INSA-GEI/Helicoptere/docs/adhesif-de-signalisation-danger-attention-aux-mai.jpg

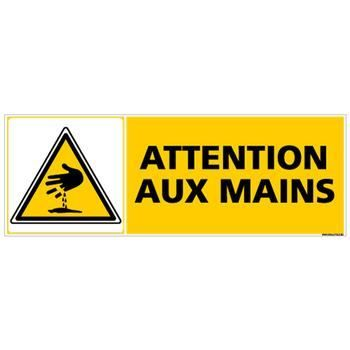
docs/adhesif-de-signalisation-danger-attention-aux-mai.jpg
