INSA-GEI/Helicoptere/docs/Danger_mains.png

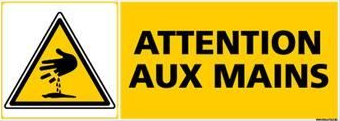
docs/Danger_mains.png
