INSA-GEI/Helicoptere/README.md

# Helicoptere
Modèle hélicoptère développé au GEI et utilisé en automatique 4éme année GEI
