INSA-GEI/Helicoptere/docs/25335-500.jpg

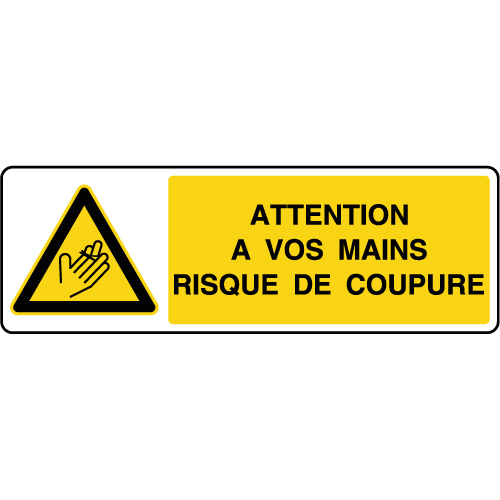
docs/25335-500.jpg
