INSA-GEI/Helicoptere/docs/AVE123_RisqueDeCoupure.jpg

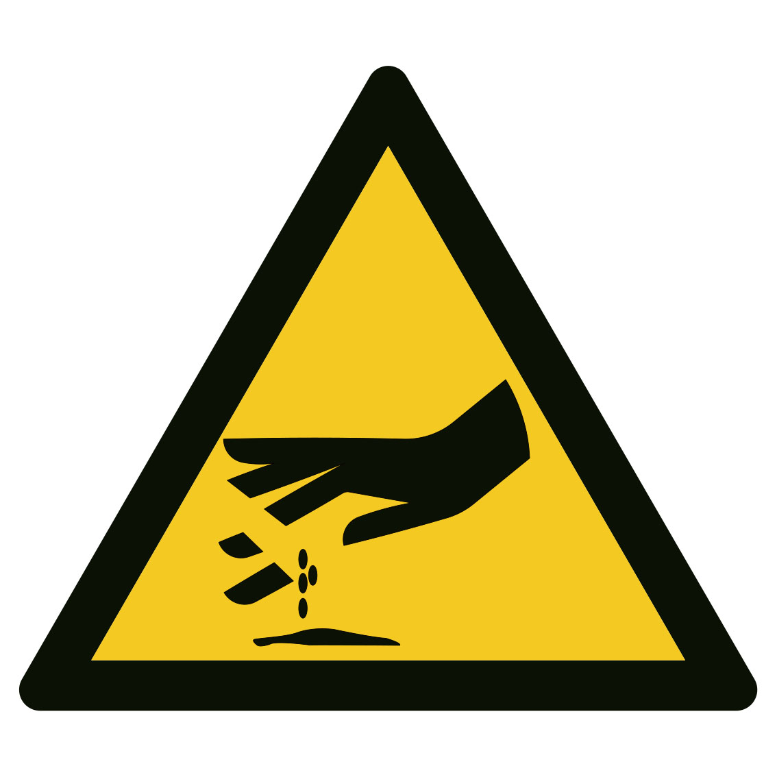
docs/AVE123_RisqueDeCoupure.jpg
