INSA-GEI/Helicoptere/docs/c0460_risque_projection-z.jpg

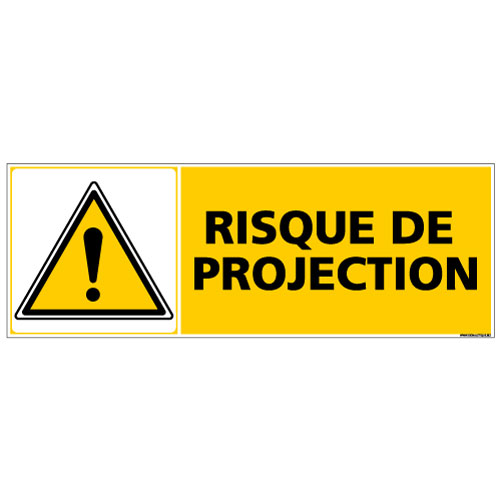
docs/c0460_risque_projection-z.jpg
