INSA-GEI/Helicoptere/docs/Danger_mains_2.png

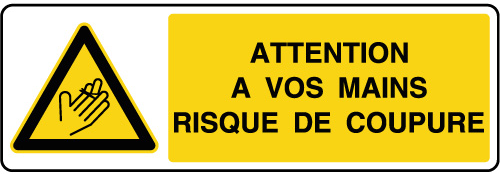
docs/Danger_mains_2.png
