INSA-GEI/Helicoptere/docs/Danger_projections.png

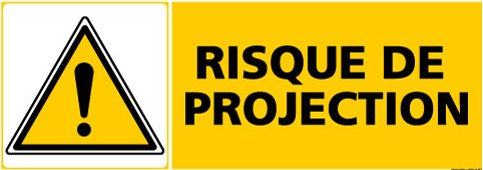
docs/Danger_projections.png
