INSA-GEI/Helicoptere/docs/StabArrowComplet.png

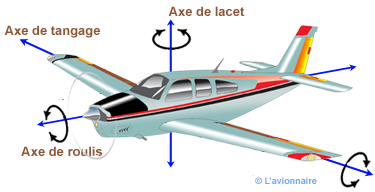
docs/StabArrowComplet.png
