INSA-GEI/Helicoptere/docs/uml/Diagramme de séquences.png

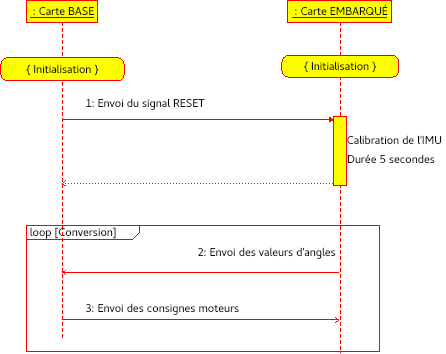
docs/uml/Diagramme de séquences.png
