INSA-GEI/Helicoptere/hardware/freecad/Helicoptere.FCStd

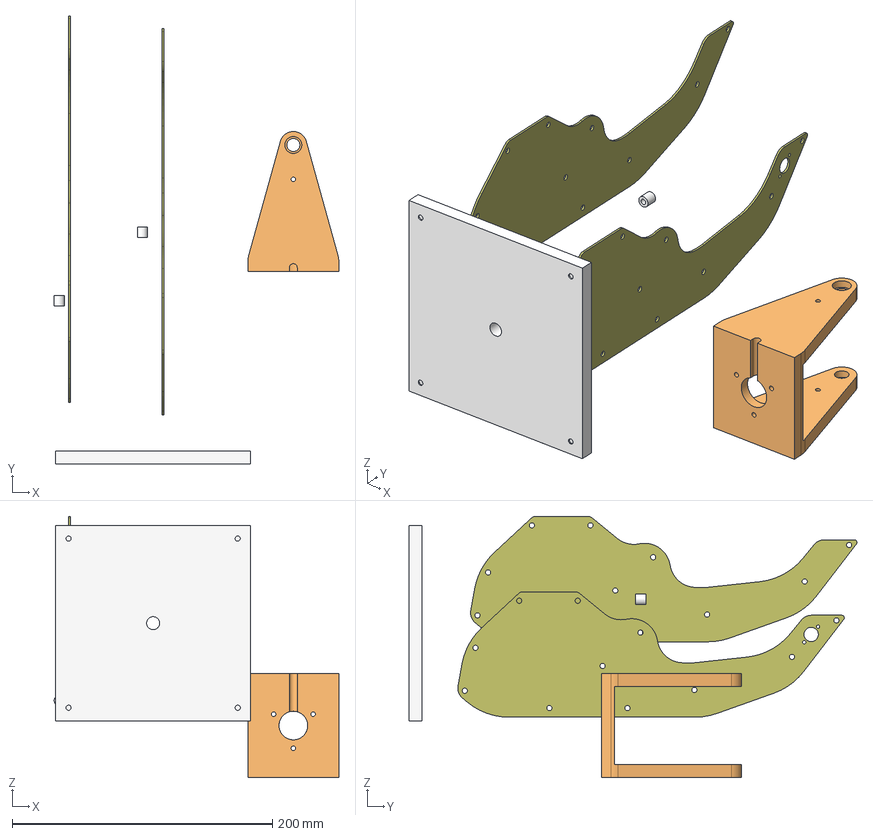
[picture p10: CAD file, 2019-09-24]
hardware/freecad/Helicoptere.FCStd
218.9 x 344.4 x 200.8 mm
Cote_Droit
Cote_Gauche
Potence
Bague_1
Bague_2
Base
