INSA-GEI/Helicoptere/pcb/Modeles 3D/STEP-WE-PD-7332-Metal-rev1.stp

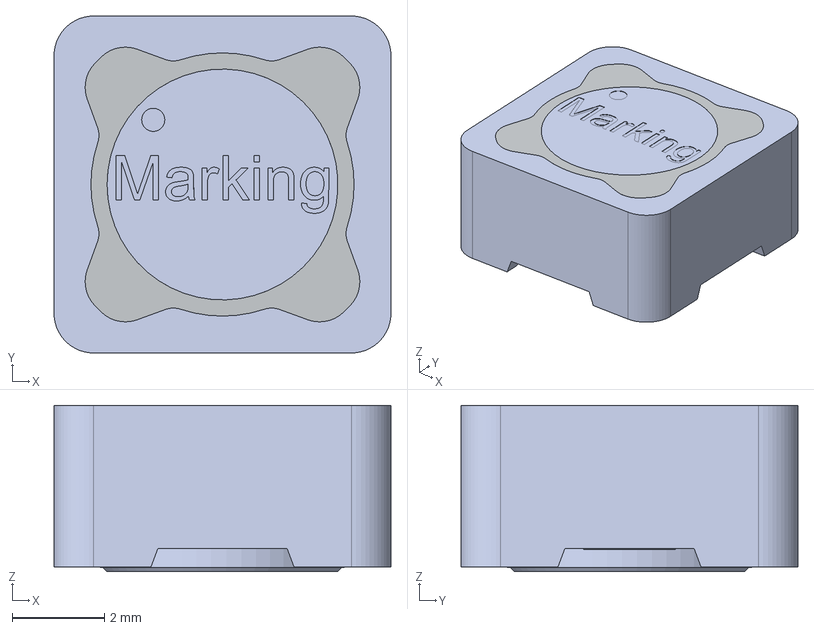
[picture p11: CAD file, 2019-10-01]
pcb/Modeles 3D/STEP-WE-PD-7332-Metal-rev1.stp
7.30 x 7.30 x 3.60 mm
Ring
Core
Base x 2
Glue x 3
