INSA-GEI/Helicoptere/hardware/Bague.step

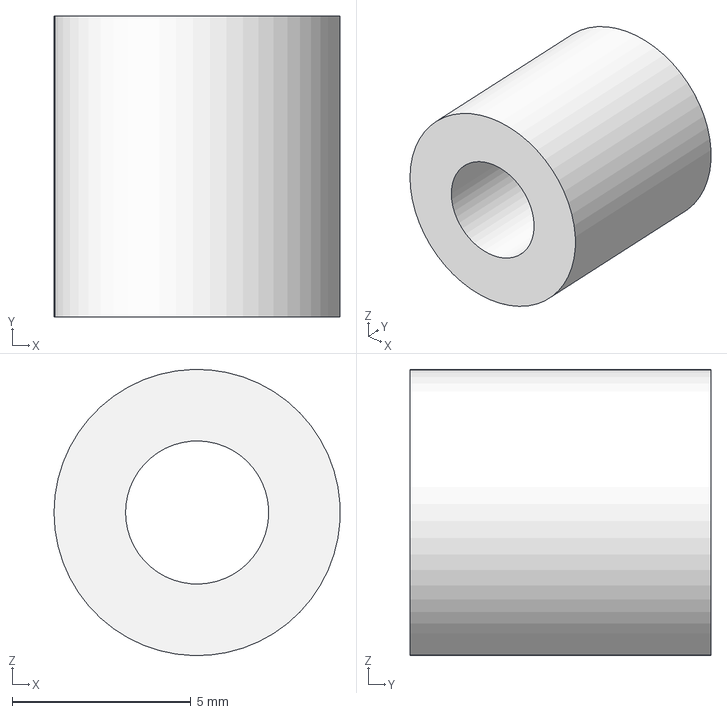
[picture p12: CAD file, 2019-09-24]
hardware/Bague.step
7.99 x 8.40 x 8.00 mm
