INSA-GEI/Helicoptere/pcb/Modeles 3D/SRN6028 series.stp

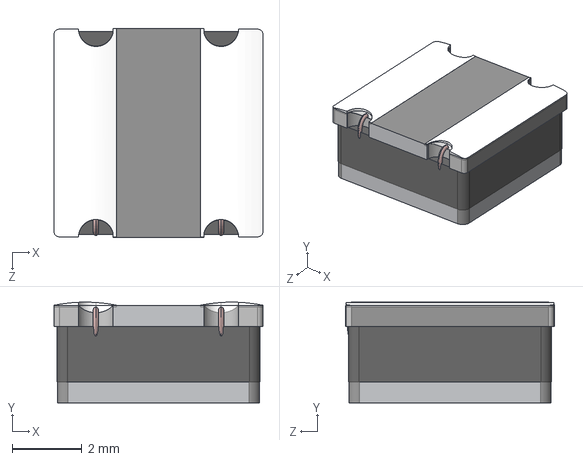
[picture p13: CAD file, 2019-10-01]
pcb/Modeles 3D/SRN6028 series.stp
6.00 x 2.89 x 6.00 mm
