INSA-GEI/Helicoptere/hardware/Base.step

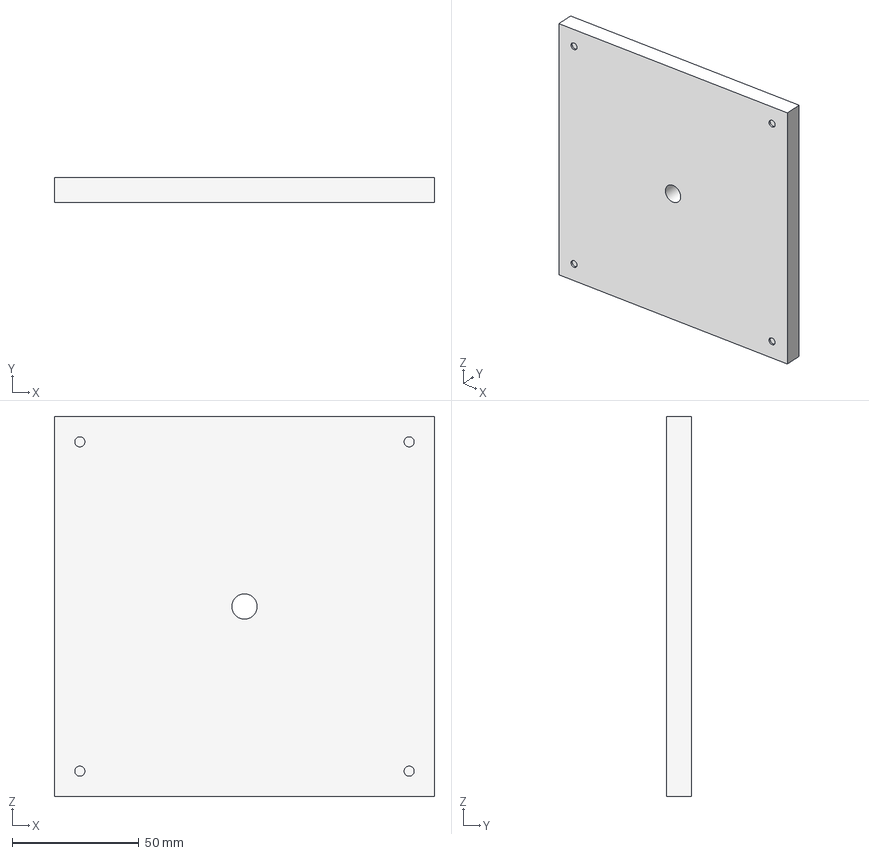
[picture p14: CAD file, 2019-09-24]
hardware/Base.step
150.0 x 10.0 x 150.0 mm
