INSA-GEI/Helicoptere/pcb/Modeles 3D/STP_MAX-WE-PD-6033-rev1.stp

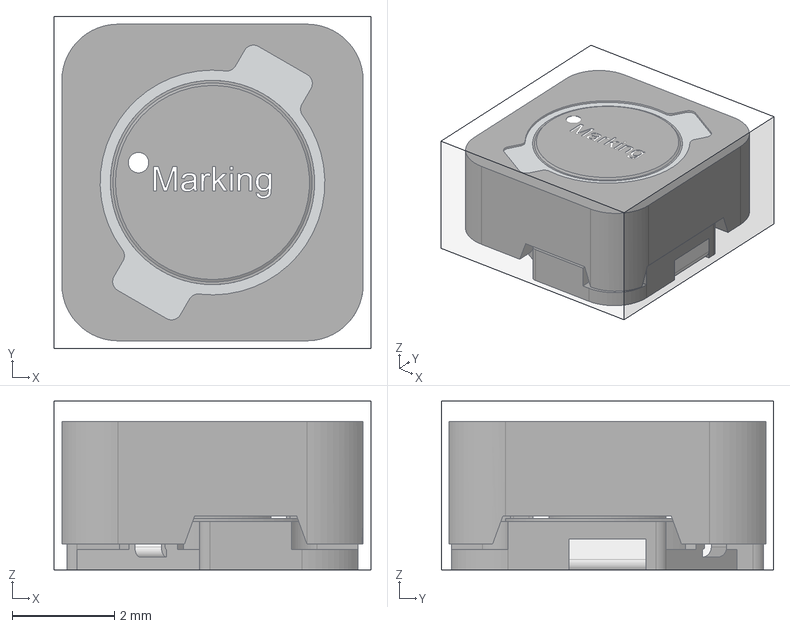
[picture p15: CAD file, 2019-10-01]
pcb/Modeles 3D/STP_MAX-WE-PD-6033-rev1.stp
6.20 x 6.50 x 3.30 mm
Base
Pin x 2
glue
Core
Shielding
MaxSized-Square
