INSA-GEI/Helicoptere/hardware/Cote_Gauche.stp

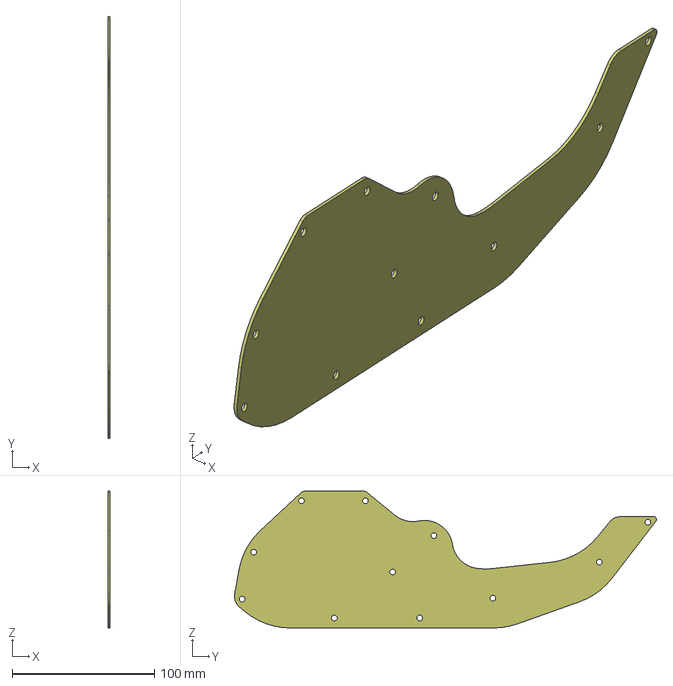
[picture p16: CAD file, 2019-09-24]
hardware/Cote_Gauche.stp
1.60 x 297.1 x 96.4 mm
