INSA-GEI/Helicoptere/pcb/Modeles 3D/STEP-WE-PD-6033-rev1.stp

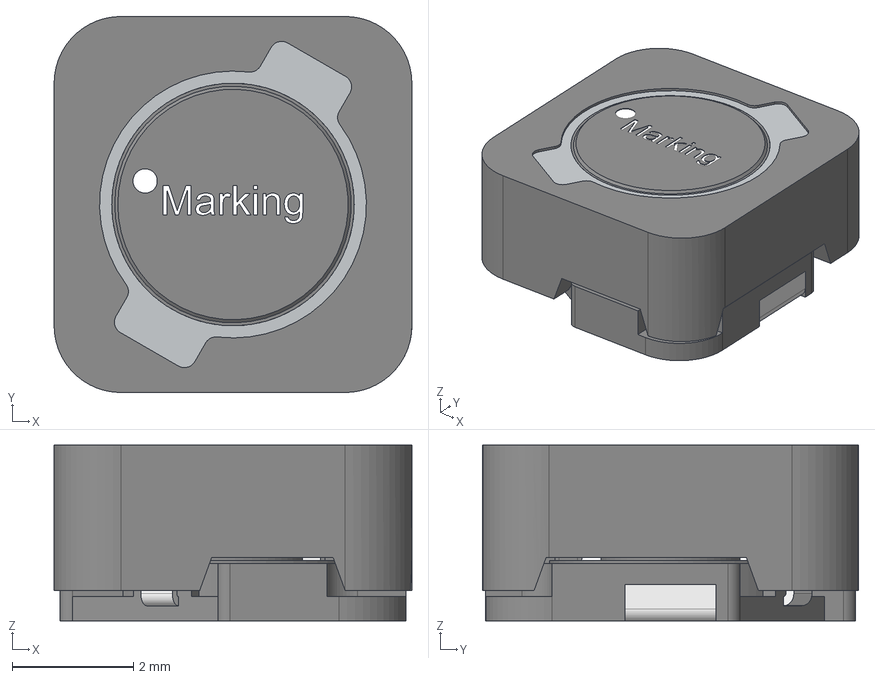
[picture p17: CAD file, 2019-10-01]
pcb/Modeles 3D/STEP-WE-PD-6033-rev1.stp
5.90 x 6.20 x 2.90 mm
Base
Pin x 2
glue
Core
Shielding
