INSA-GEI/Helicoptere/hardware/Potence.step

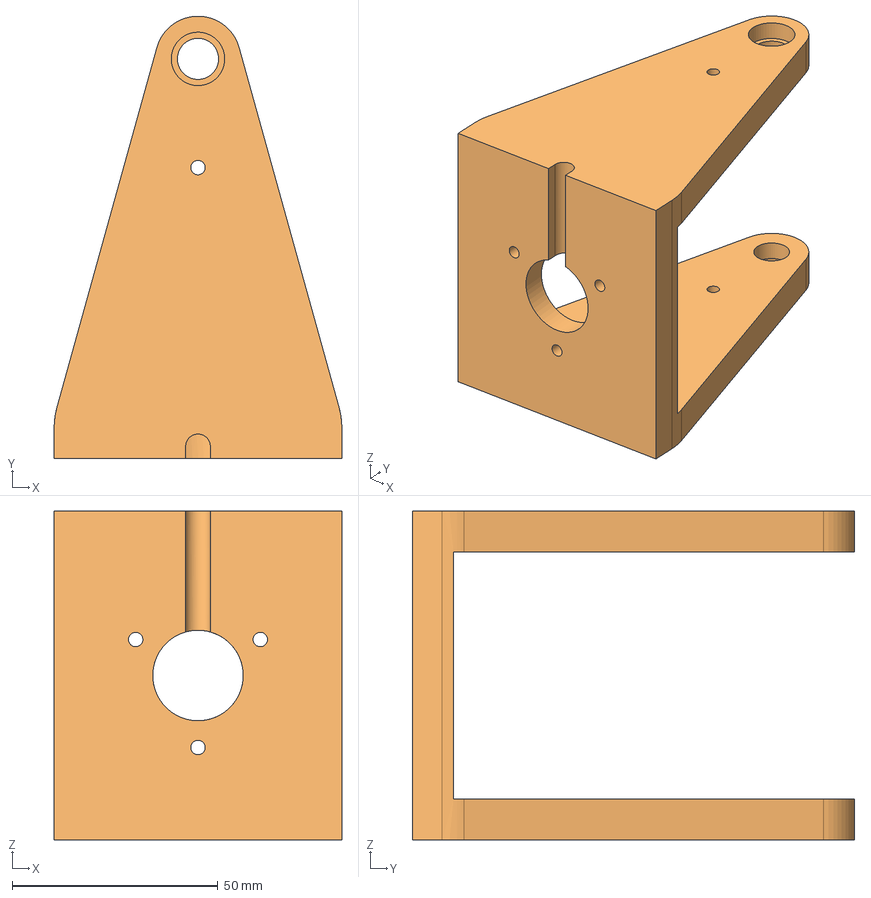
[picture p18: CAD file, 2019-09-24]
hardware/Potence.step
70.0 x 107.6 x 80.0 mm
