INSA-GEI/Helicoptere/(list of files, cad)

Other CAD files:
hardware/Raccord-Mat-Potence.dwg
hardware/Fixation-potar.dwg
hardware/Cote_Droit.stp
hardware/Bague.dwg
hardware/Bague.ipt
hardware/Base.ipt
hardware/Bouchon PVC.ipt
hardware/Cote_Droit.ipt
hardware/Cote_Droit.stl
hardware/Cote_Gauche.ipt
hardware/Cote_Gauche.stl
hardware/Entretoise-50mm.ipt
hardware/Equerre-Potar.ipt
hardware/Fixation-potar.ipt
hardware/Fixation_moteur.ipt
hardware/Helice 4.5x4.5.ipt
hardware/Helice 7x3.ipt
hardware/Helicopter_INSA_150.iam
hardware/Mat.ipt
hardware/Nidec_DMN29.ipt
hardware/Nidec_DMN37.ipt
hardware/Pied.ipt
hardware/Potence.ipt
hardware/Raccord-Mat-Potence.ipt
hardware/Roulement.ipt
hardware/SRC022.ipt
hardware/Tube-4mm.ipt
hardware/Vis-Pivot.ipt
hardware/Vishay-157.ipt
hardware/freecad/Bague.FCStd
hardware/freecad/Base.FCStd
