INSA-GEI/Helicoptere/pcb/carte_embarque/carte_embarque.pdf

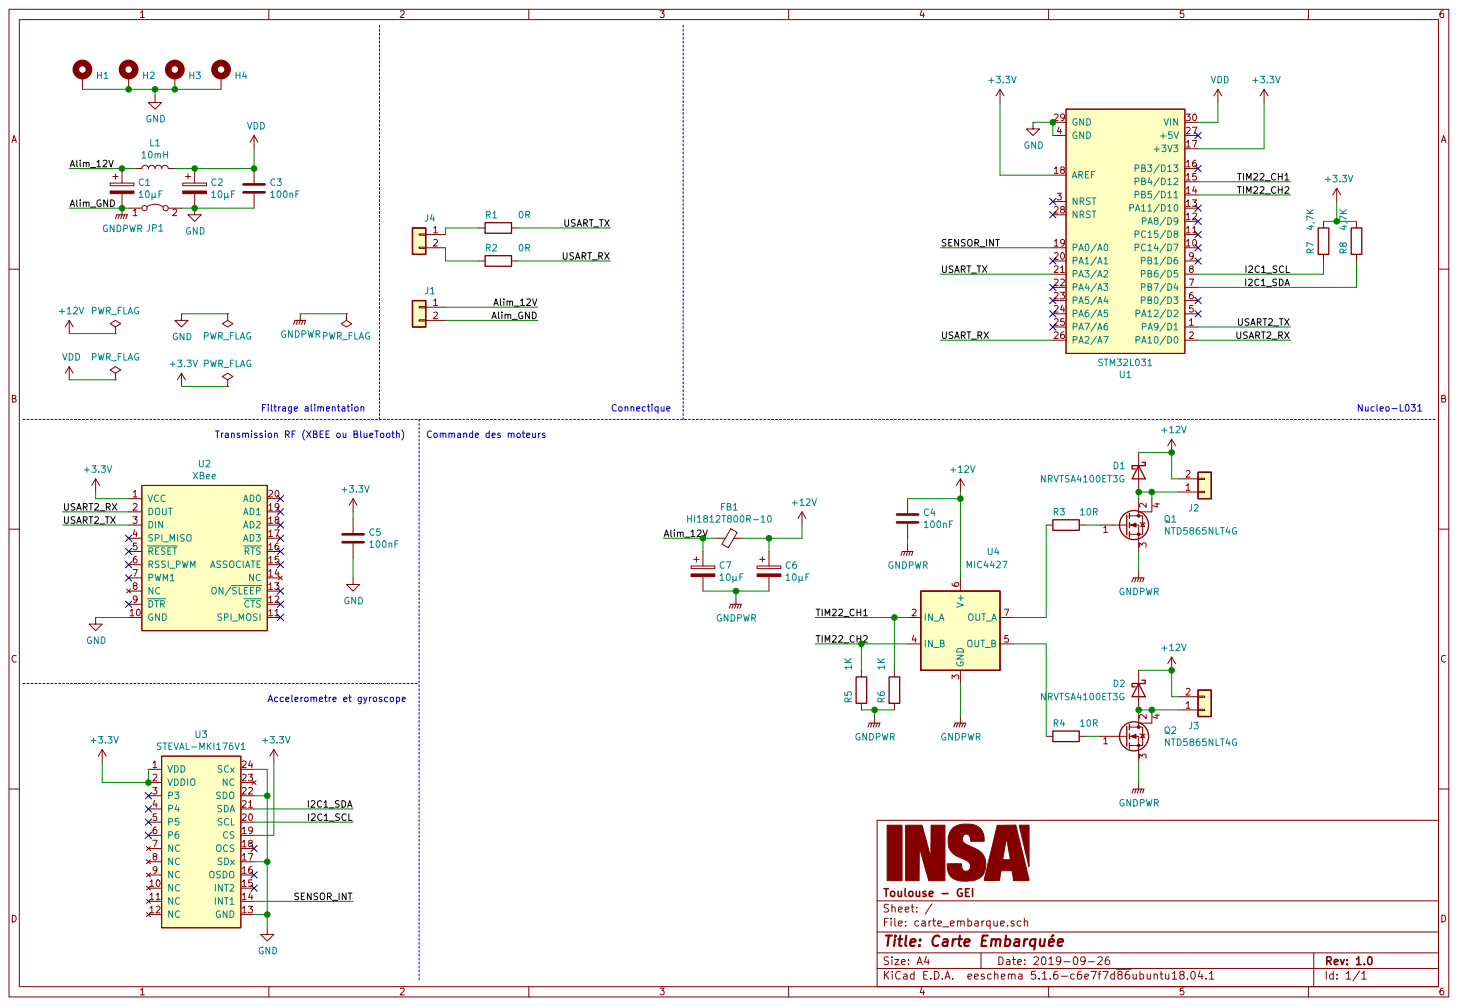
[picture p19: page 1]

File: carte_embarque.sch Sheet: / Toulouse - GEI

Id: 1/1 Title: Carte Embarquée
