INSA-GEI/Helicoptere/pcb/carte_embarque/carte_embarque.kicad_pcb

## KiCad design pcb/carte_embarque/carte_embarque.kicad_pcb (2019-10-11)

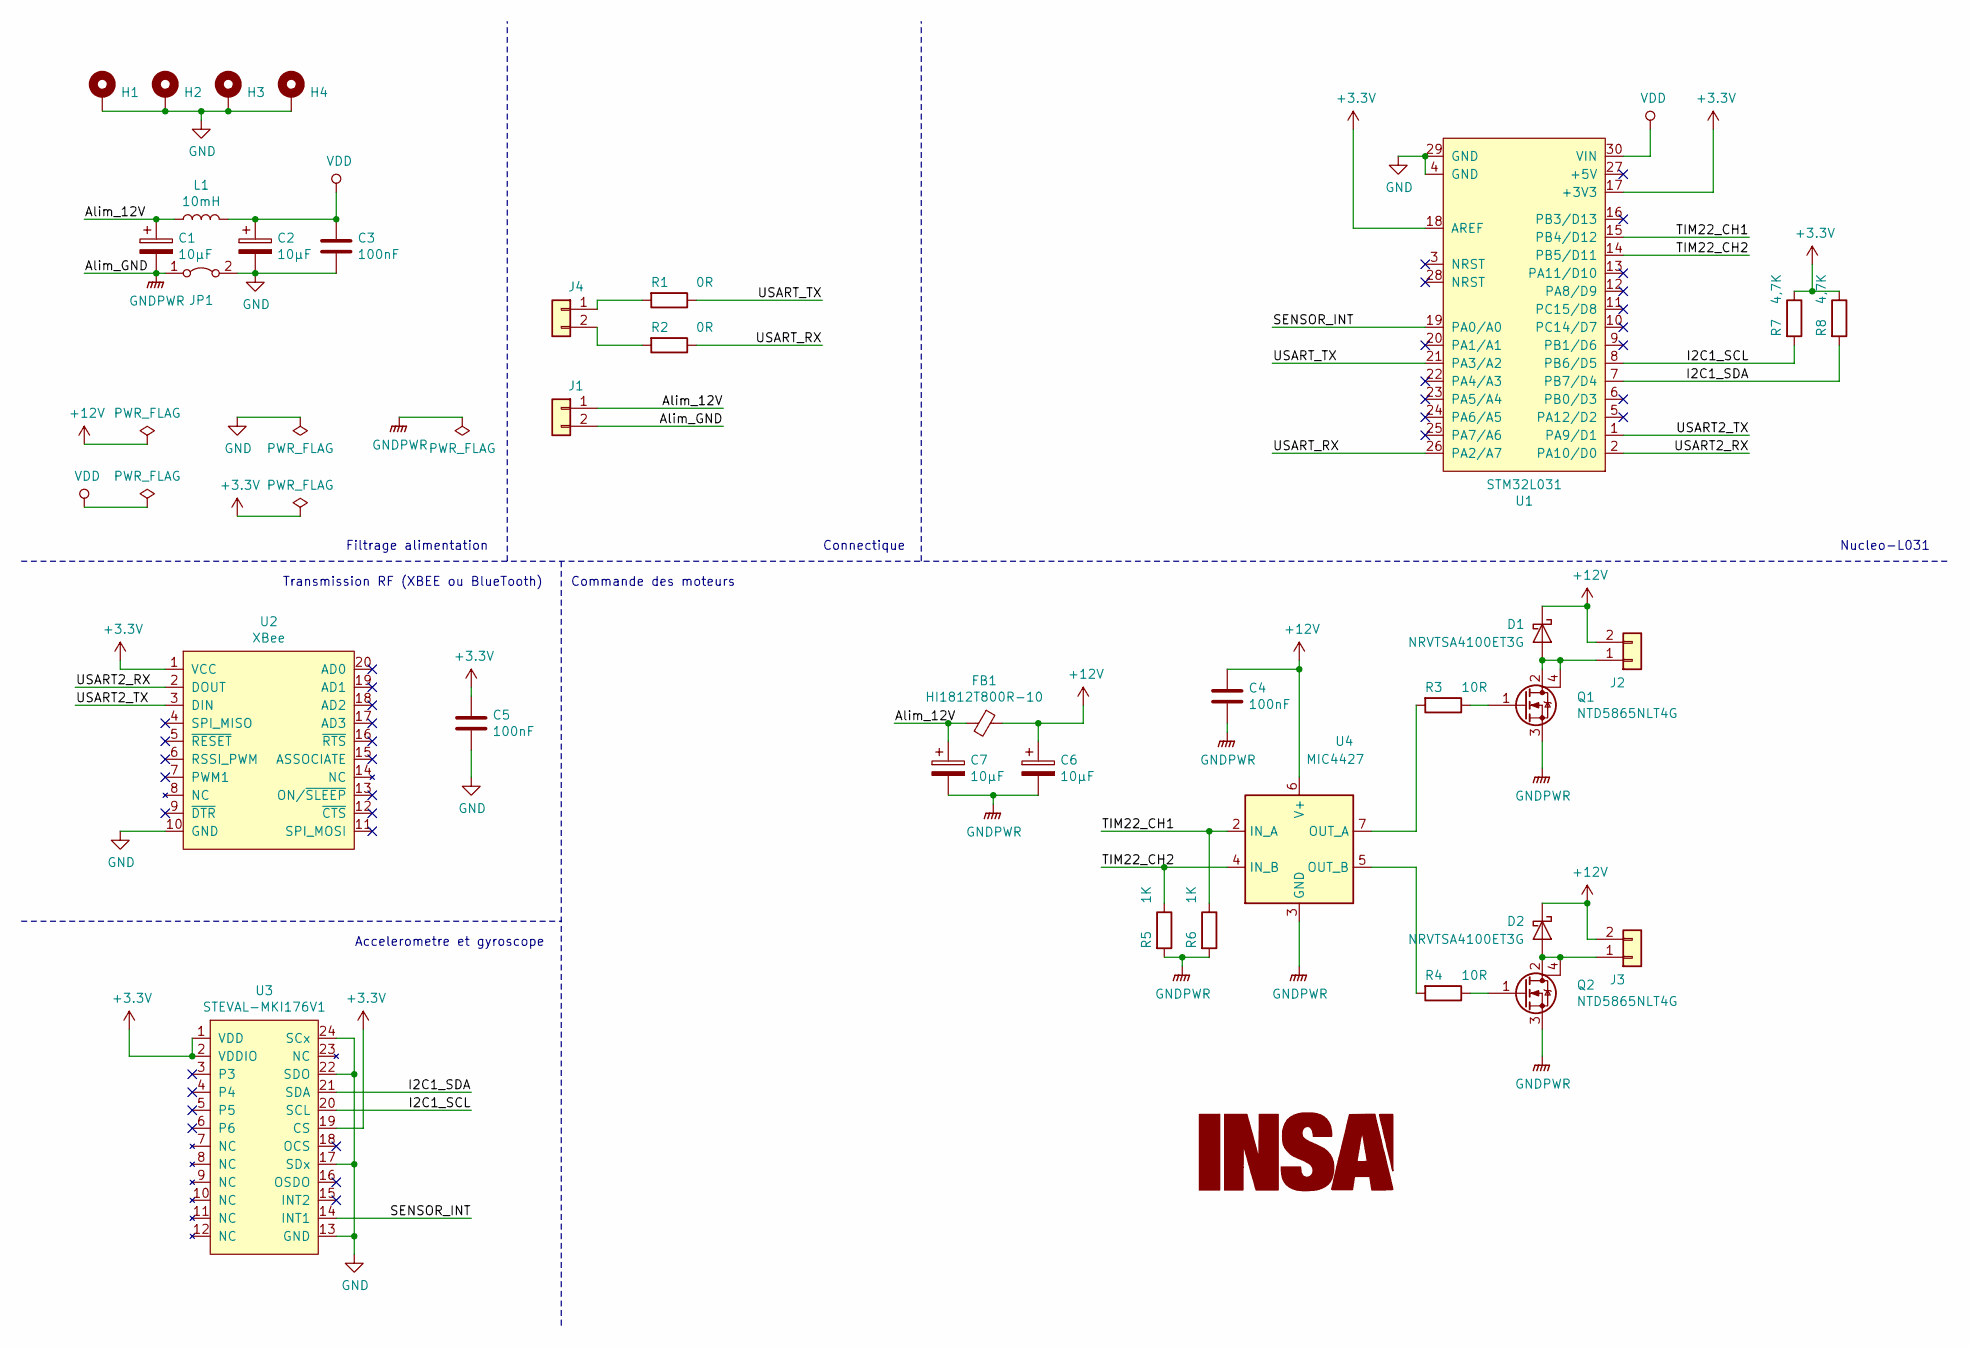
[picture p20: schematic carte_embarque.sch, Carte BASE]

Parts:
C1, C2, C6, C7: 10µF; CP_EIA-7343-31_Kemet-D
C3, C4, C5: 100nF; C_1206_3216Metric_Pad1.42x1.75mm_HandSolder
D1, D2: NRVTSA4100ET3G; D_SMA_Handsoldering
FB1: HI1812T800R-10; L_1812_4532Metric_Pad1.30x3.40mm_HandSolder
H1, H2, H3, H4: MountingHole_Pad; MountingHole_3.2mm_M3_ISO14580_Pad
J1, J2, J3: Conn_01x02; JST_VH_B2PS-VH_1x02_P3.96mm_Horizontal
J4: Conn_01x02; DF3A-2P-2DS
JP1: Jumper_2_Bridged; SolderJumper-2_P1.3mm_Bridged2Bar_RoundedPad1.0x1.5mm
L1: 10mH; L_Wuerth_WE-PD2-Typ-L
Q1, Q2: NTD5865NLT4G; TO-252-3_TabPin4
R1, R2: 0R; R_1206_3216Metric_Pad1.42x1.75mm_HandSolder
R3, R4: 10R; R_1206_3216Metric_Pad1.42x1.75mm_HandSolder
R5, R6: 1K; R_1206_3216Metric_Pad1.42x1.75mm_HandSolder
R7, R8: 4,7K; R_1206_3216Metric_Pad1.42x1.75mm_HandSolder
U1: STM32L031; STM32-Nucleo-32
U2: XBee; Xbee3
U3: STEVAL-MKI176V1; DIP-24_W15.24mm_Socket_LongPads
U4: MIC4427; SOIC-8_3.9x4.9mm_P1.27mm

Connections:
+3V3: C5.1, R7.1, R8.1, U1.17 (+3V3), U1.18 (AREF), U2.1 (VCC), U3.1 (VDD), U3.2 (VDDIO), U3.19 (CS)
+12V: C4.1, C6.1, D1.1 (K), D2.1 (K), FB1.1, J2.2, J3.2, U4.6 (V+)
/Alim_12V: C1.1, C7.1, FB1.2, J1.1, L1.1
/I2C1_SCL: R7.2, U1.8 (PB6/D5), U3.20 (SCL)
/I2C1_SDA: R8.2, U1.7 (PB7/D4), U3.21 (SDA)
/SENSOR_INT: U1.19 (PA0/A0), U3.14 (INT1)
/TIM22_CH1: R6.1, U1.15 (PB4/D12), U4.2 (IN_A)
/TIM22_CH2: R5.1, U1.14 (PB5/D11), U4.4 (IN_B)
/USART2_RX: U1.2 (PA10/D0), U2.2 (DOUT)
/USART2_TX: U1.1 (PA9/D1), U2.3 (DIN)
/USART_RX: R2.1, U1.26 (PA2/A7)
/USART_TX: R1.1, U1.21 (PA3/A2)
GND: C2.2, C3.2, C5.2, H1.1, H2.1, H3.1, H4.1, JP1.2 (B), U1.4 (GND), U1.29 (GND), U2.10 (GND), U3.13 (GND), U3.17 (SDx), U3.22 (SDO), U3.24 (SCx)
GNDPWR: C1.2, C4.2, C6.2, C7.2, J1.2, JP1.1 (A), Q1.3 (S), Q2.3 (S), R5.2, R6.2, U4.3 (GND)
unnamed: D1.2 (A), J2.1, Q1.2 (D), Q1.4 (D)
unnamed: D2.2 (A), J3.1, Q2.2 (D), Q2.4 (D)
unnamed: J4.1, R1.2
unnamed: J4.2, R2.2
unnamed: Q1.1 (G), R3.1
unnamed: Q2.1 (G), R4.1
unnamed: R3.2, U4.7 (OUT_A)
unnamed: R4.2, U4.5 (OUT_B)
VDD: C2.1, C3.1, L1.2, U1.30 (VIN)

Notes on the sheet:
Filtrage alimentation
Connectique
Nucleo-L031
Transmission RF (XBEE ou BlueTooth)
Commande des moteurs
Accelerometre et gyroscope

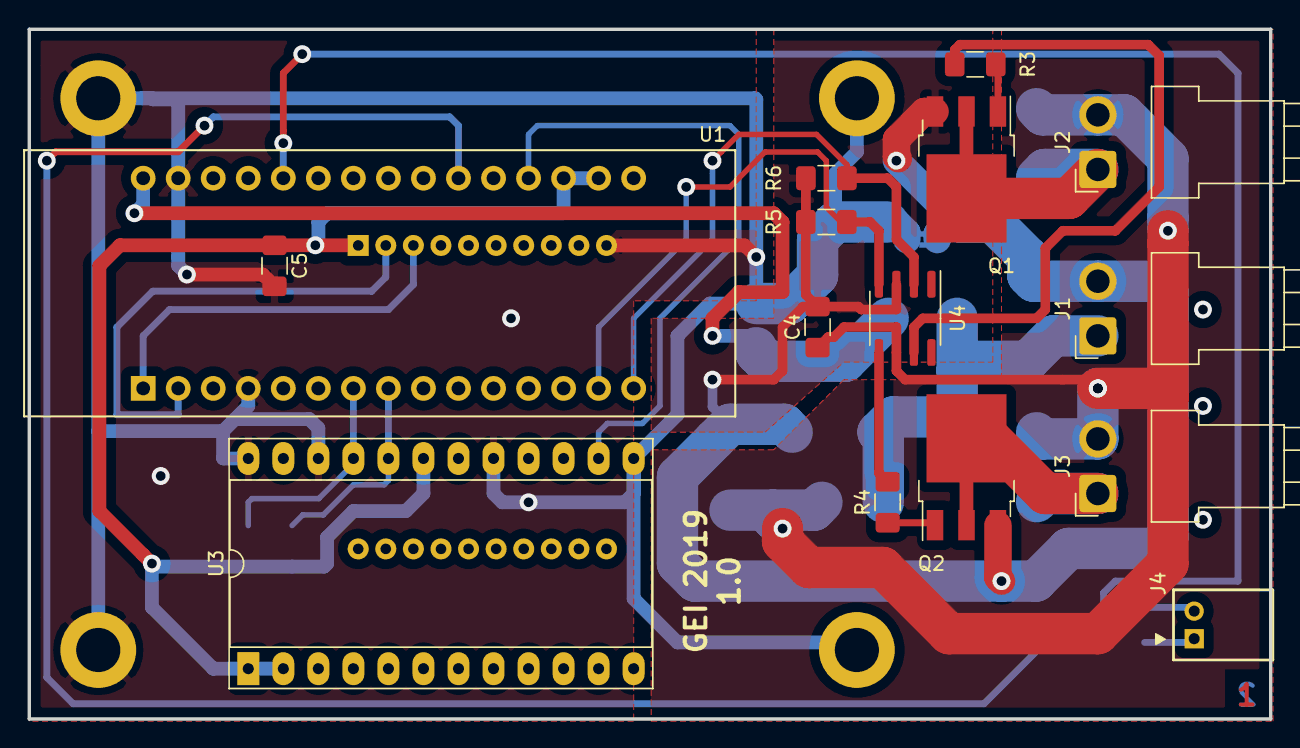
[picture p21: board carte_embarque.kicad_pcb from above]

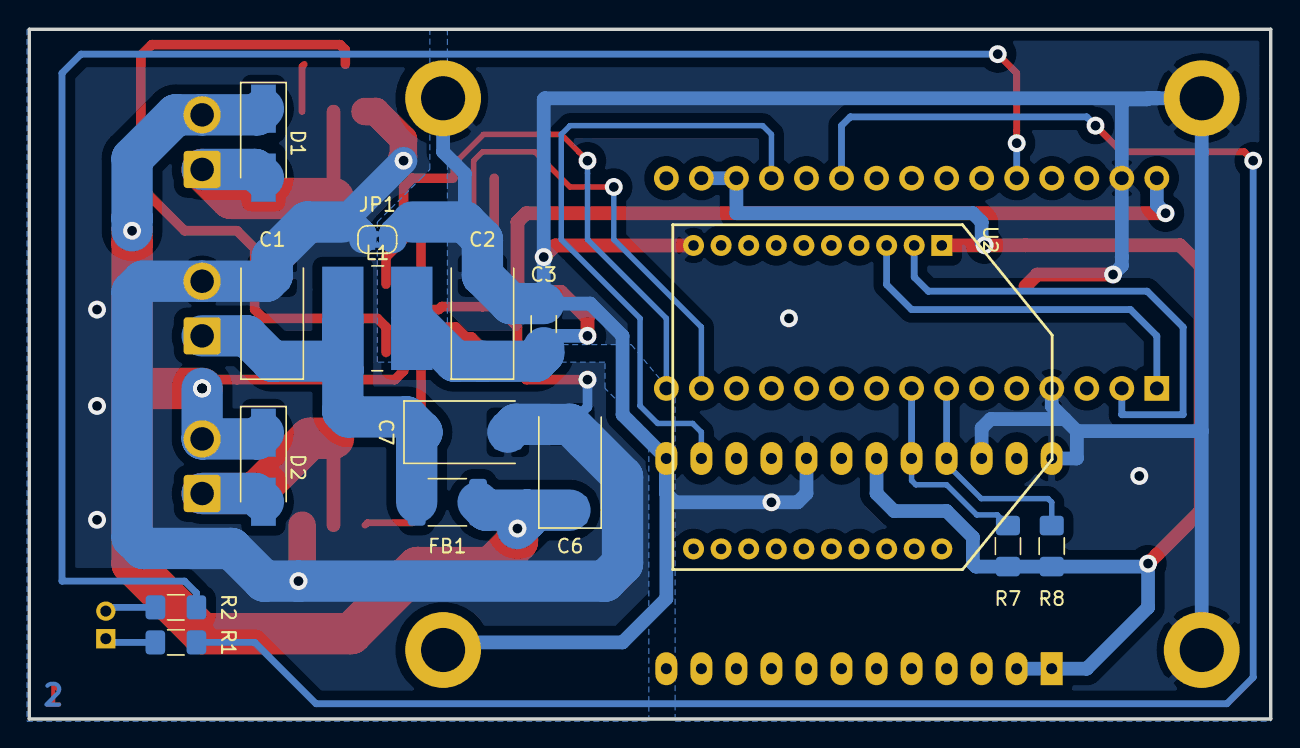
[picture p22: board carte_embarque.kicad_pcb from below]

Board: 2 copper layers, 90.0 x 50.0 mm, 34 parts (15 on the bottom side), 23 nets.
