INSA-GEI/Helicoptere/pcb/carte_base/carte_base.kicad_pcb

## KiCad design pcb/carte_base/carte_base.kicad_pcb (2019-10-11)

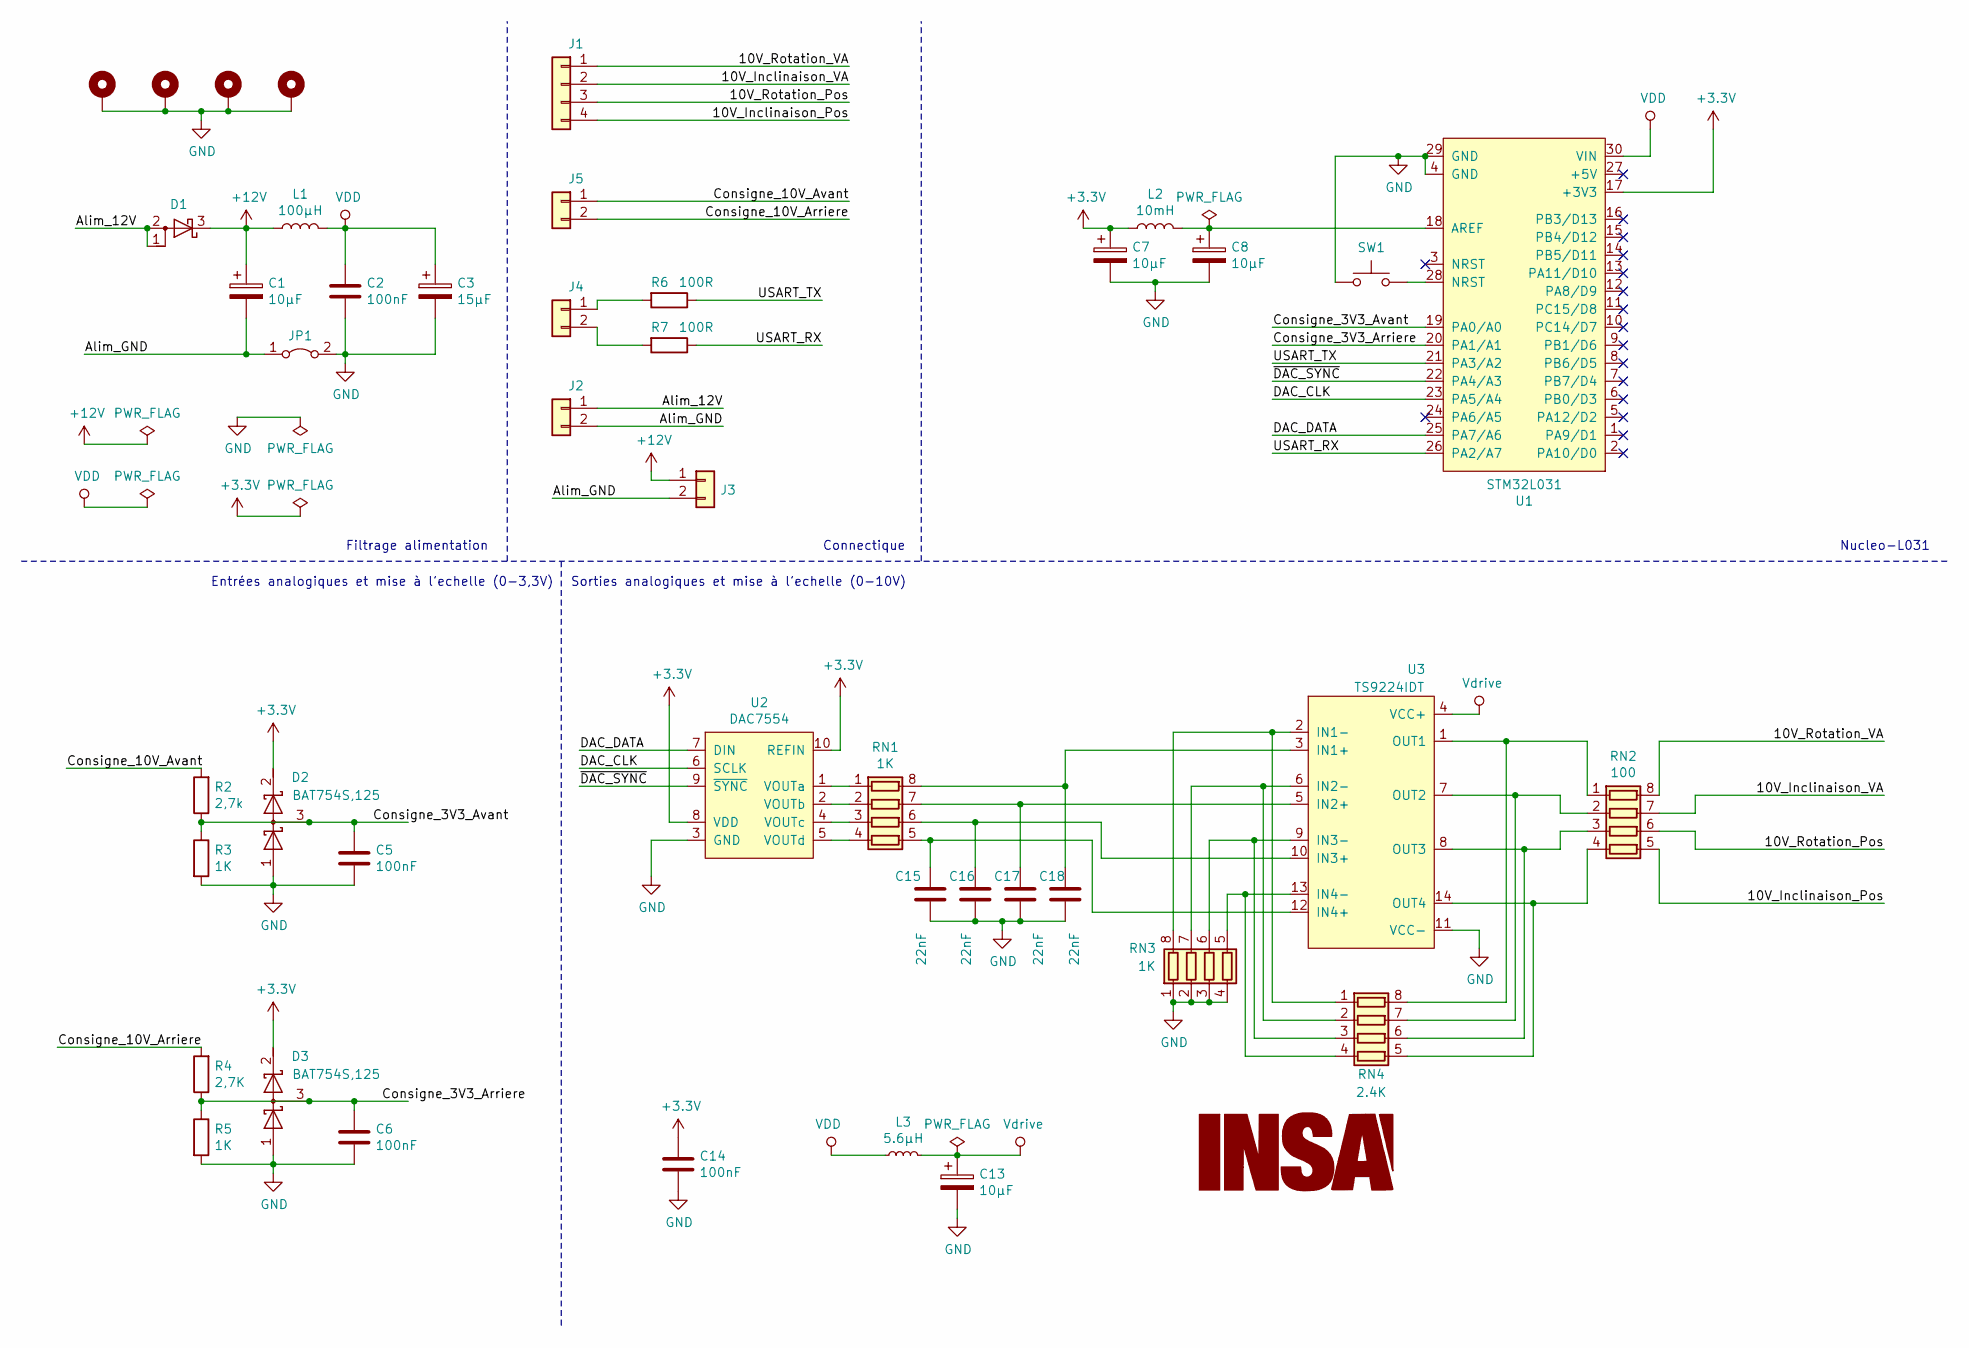
[picture p23: schematic carte_base.sch, Carte BASE]

Parts:
C1, C7, C8, C13: 10µF; CP_EIA-7343-31_Kemet-D
C2, C5, C6, C14: 100nF; C_1206_3216Metric_Pad1.42x1.75mm_HandSolder
C3: 15µF; CP_EIA-7343-31_Kemet-D
C15, C16, C17, C18: 22nF; C_1206_3216Metric_Pad1.42x1.75mm_HandSolder
D1: D_Schottky_AAK; TO-277A
D2, D3: BAT754S,125; SOT-23
H1, H2, H3, H4: MountingHole_Pad; MountingHole_3.2mm_M3_ISO14580_Pad
J1: Conn_01x04; DF3A-4P-2DS
J2, J3: Conn_01x02; JST_VH_B2PS-VH_1x02_P3.96mm_Horizontal
J4, J5: Conn_01x02; DF3A-2P-2DS
JP1: Jumper_2_Bridged; SolderJumper-2_P1.3mm_Bridged2Bar_RoundedPad1.0x1.5mm
L1: 100µH; L_Bourns-SRN6028
L2: 10mH; L_Wuerth_WE-PD2-Typ-L
L3: 5.6µH; L_1812_4532Metric_Pad1.30x3.40mm_HandSolder
R2: 2,7k; R_1206_3216Metric_Pad1.42x1.75mm_HandSolder
R3, R5: 1K; R_1206_3216Metric_Pad1.42x1.75mm_HandSolder
R4: 2,7K; R_1206_3216Metric_Pad1.42x1.75mm_HandSolder
R6, R7: 100R; R_1206_3216Metric_Pad1.42x1.75mm_HandSolder
RN1, RN3: 1K; R_Array_Convex_4x0603
RN2: 100; R_Array_Convex_4x0603
RN4: 2.4K; R_Array_Convex_4x0603
SW1: FSMRA3JH04; SW_Tactile_SPST_Angled_PTS645Vx58-2LFS
U1: STM32L031; STM32-Nucleo-32
U2: DAC7554; MSOP-10_3x3mm_P0.5mm
U3: TS9224IDT; SOIC-14_3.9x8.7mm_P1.27mm

Connections:
+3V3: C7.1, C14.1, D2.2 (K), D3.2 (K), L2.1, U1.17 (+3V3), U2.8 (VDD), U2.10 (REFIN)
+12V: C1.1, D1.3 (K), J3.1, L1.1
/10V_Inclinaison_Pos: J1.4, RN2.5 (R4.2)
/10V_Inclinaison_VA: J1.2, RN2.7 (R2.2)
/10V_Rotation_Pos: J1.3, RN2.6 (R3.2)
/10V_Rotation_VA: J1.1, RN2.8 (R1.2)
/Alim_12V: D1.1 (A), D1.2 (A), J2.1
/Alim_GND: C1.2, J2.2, J3.2, JP1.1 (A)
/Consigne_3V3_Arriere: C6.1, D3.3 (common), R4.1, R5.1, U1.20 (PA1/A1)
/Consigne_3V3_Avant: C5.1, D2.3 (common), R2.1, R3.1, U1.19 (PA0/A0)
/Consigne_10V_Arriere: J5.2, R4.2
/Consigne_10V_Avant: J5.1, R2.2
/DAC_CLK: U1.23 (PA5/A4), U2.6 (SCLK)
/DAC_DATA: U1.25 (PA7/A6), U2.7 (DIN)
/USART_RX: R7.1, U1.26 (PA2/A7)
/USART_TX: R6.1, U1.21 (PA3/A2)
/~DAC_SYNC: U1.22 (PA4/A3), U2.9 (~SYNC)
GND: C2.2, C3.2, C5.2, C6.2, C7.2, C8.2, C13.2, C14.2, C15.2, C16.2, C17.2, C18.2, D2.1 (A), D3.1 (A), H1.1, H2.1, H3.1, H4.1, JP1.2 (B), R3.2, R5.2, RN3.1 (R1.1), RN3.2 (R2.1), RN3.3 (R3.1), RN3.4 (R4.1), SW1.1, U1.4 (GND), U1.29 (GND), U2.3 (GND), U3.11 (VCC-)
unnamed: C8.1, L2.2, U1.18 (AREF)
unnamed: C15.1, RN1.5 (R4.2), U3.12 (IN4+)
unnamed: C16.1, RN1.6 (R3.2), U3.10 (IN3+)
unnamed: C17.1, RN1.7 (R2.2), U3.5 (IN2+)
unnamed: C18.1, RN1.8 (R1.2), U3.3 (IN1+)
unnamed: J4.1, R6.2
unnamed: J4.2, R7.2
unnamed: RN1.1 (R1.1), U2.1 (VOUTa)
unnamed: RN1.2 (R2.1), U2.2 (VOUTb)
unnamed: RN1.3 (R3.1), U2.4 (VOUTc)
unnamed: RN1.4 (R4.1), U2.5 (VOUTd)
unnamed: RN2.1 (R1.1), RN4.8 (R1.2), U3.1 (OUT1)
unnamed: RN2.2 (R2.1), RN4.7 (R2.2), U3.7 (OUT2)
unnamed: RN2.3 (R3.1), RN4.6 (R3.2), U3.8 (OUT3)
unnamed: RN2.4 (R4.1), RN4.5 (R4.2), U3.14 (OUT4)
unnamed: RN3.5 (R4.2), RN4.4 (R4.1), U3.13 (IN4-)
unnamed: RN3.6 (R3.2), RN4.3 (R3.1), U3.9 (IN3-)
unnamed: RN3.7 (R2.2), RN4.2 (R2.1), U3.6 (IN2-)
unnamed: RN3.8 (R1.2), RN4.1 (R1.1), U3.2 (IN1-)
unnamed: SW1.2, U1.28 (NRST)
VDD: C2.1, C3.1, L1.2, L3.2, U1.30 (VIN)
Vdrive: C13.1, L3.1, U3.4 (VCC+)

Notes on the sheet:
Filtrage alimentation
Connectique
Nucleo-L031
Entrées analogiques et mise à l'echelle (0-3,3V)
Sorties analogiques et mise à l'echelle (0-10V)

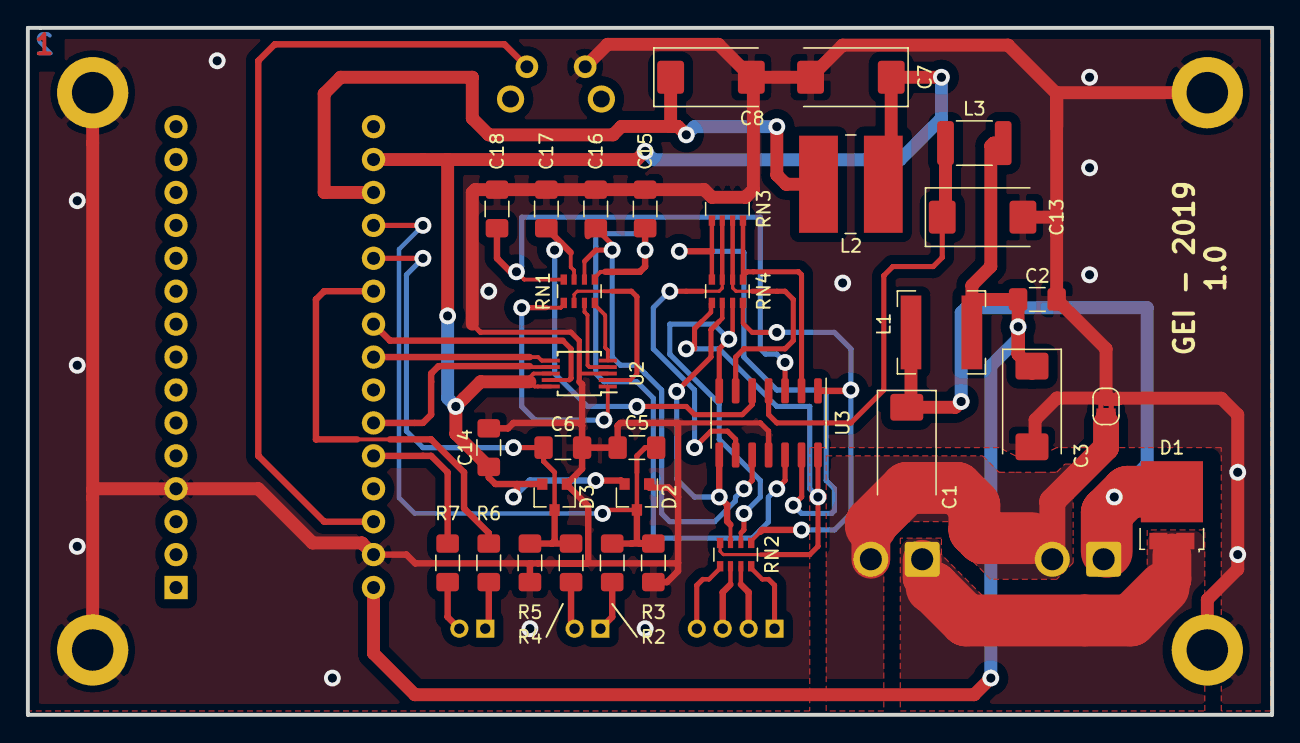
[picture p24: board carte_base.kicad_pcb from above]

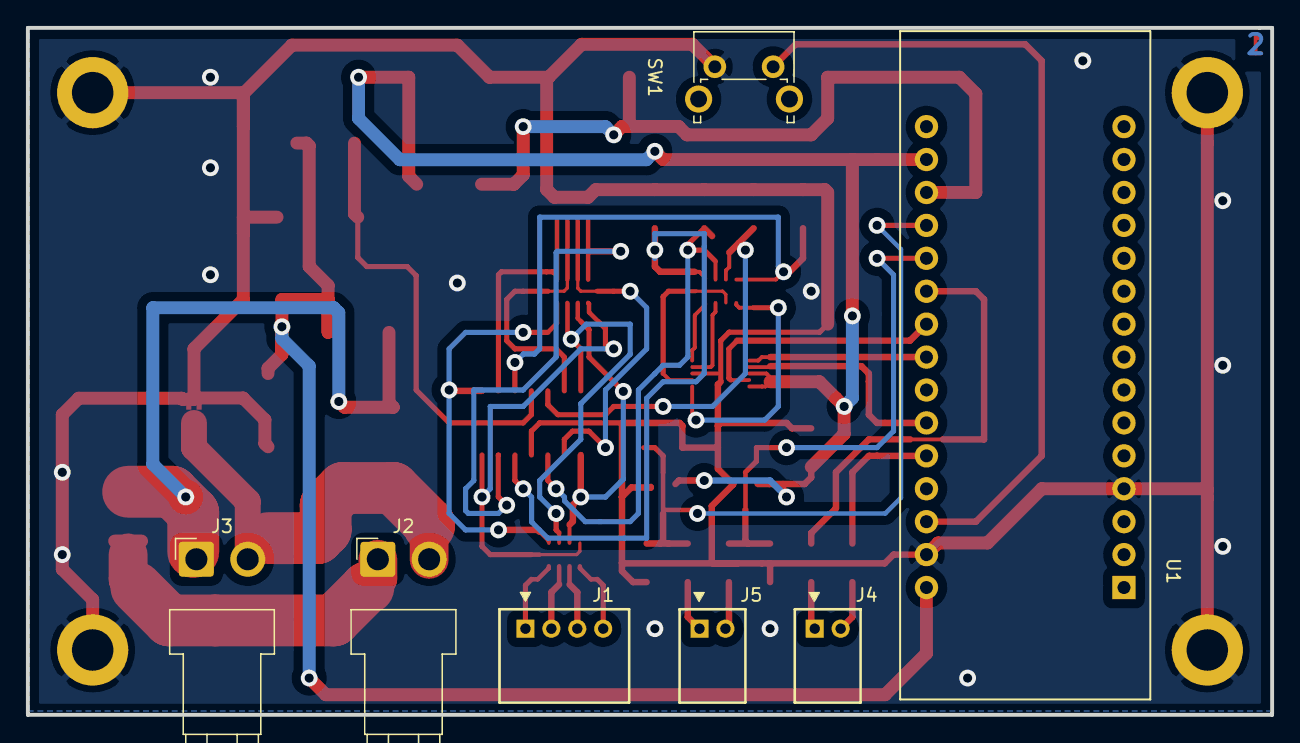
[picture p25: board carte_base.kicad_pcb from below]

Board: 2 copper layers, 96.0 x 53.0 mm, 43 parts (7 on the bottom side), 40 nets.
