INSA-GEI/Helicoptere/software/Helicoptere_Base/Src/main.c

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

/* Includes ------------------------------------------------------------------*/
#include "main.h"
#include "adc.h"

#include "spidac.h"
#include "led.h"
#include "usart.h"

#include <stdio.h>
#include <string.h>
#include <stdlib.h>

/* USER CODE BEGIN Includes */
volatile uint8_t SYSTICK_1msEvent=0;
void ReceptionCallback(char* data, uint16_t size);
void ConvertOutputValues (int32_t valAnglePitch,int32_t valAngleYaw,int32_t valMdpsPitch,int32_t valMdpsYaw);
void Cmdprocessor(char* data, uint16_t size);

/* USER CODE END Includes */

#define FRONT_CMD	0
#define REAR_CMD	1

#define ANGLE_PITCH	0
#define MDPS_PITCH	1
#define ANGLE_YAW	2
#define MDPS_YAW 	3

/* USER CODE BEGIN PV */
uint32_t InputValues[2]={0};
uint32_t OutputValues[4]={0};
const uint32_t DAC_CALIBRATION[]={3845,3900,3890,3885}; // DAC values for 10V output, per channel
const uint32_t ADC_CALIBRATION[]={0,0}; //ADC values for 10V input, per channel

char SendBuffer[100];
char RcvBuffer[100];
char ResetString[] = "ATRS\n\r\0";

volatile int32_t testAnglePitch, testAngleYaw, testMdpsPitch, testMdpsYaw=0;
volatile int32_t valAnglePitch,valAngleYaw,valMdpsPitch,valMdpsYaw=0;

volatile int messageCounter=0;
volatile char messageReceived=0;
volatile int counter_10ms=0;
/* USER CODE END PV */

void SystemClock_Config(void);
/**
 * @brief  The application entry point.
 * @retval int
 */
int main(void)
{
	/* MCU Configuration--------------------------------------------------------*/

	/* Reset of all peripherals, Initializes the Flash interface and the Systick. */
	HAL_DeInit();
	HAL_Init();

	/* Configure the system clock */
	SystemClock_Config();

	/* Initialize all configured peripherals */
	DEBUG_Init();
	LED_Init();
	LED_SetMode(LED_MODE_ON);

	ADC_Init();
	SPIDAC_Init();

	UART_Init();
	messageReceived=0;
	UART_AddReceptionCallback(ReceptionCallback);
	UART_StartReception();

	/* Envoi de la commande Reset à la carte embarqué (arret moteurs + recalibration AHRS) */
	UART_SendData(ResetString, strlen(ResetString));

	/* Infinite loop */
	/* USER CODE BEGIN WHILE */

	LED_SetMode(LED_MODE_ERROR);

	while (1)
	{
		/* USER CODE END WHILE */
		if (SYSTICK_1msEvent==1)
		{
			SYSTICK_1msEvent=0;

			counter_10ms++;
			if (counter_10ms>=10)
			{
				counter_10ms=0;
				// Send output values to dac
				SPIDAC_SetValue(SPIDAC_CHANNEL_ANGLE_PITCH, (uint16_t)OutputValues[ANGLE_PITCH]);
				SPIDAC_SetValue(SPIDAC_CHANNEL_MDPS_PITCH, (uint16_t)OutputValues[MDPS_PITCH]);
				SPIDAC_SetValue(SPIDAC_CHANNEL_ANGLE_YAW, (uint16_t)OutputValues[ANGLE_YAW]);
				SPIDAC_SetValue(SPIDAC_CHANNEL_MDPS_YAW, (uint16_t)OutputValues[MDPS_YAW]);
				SPIDAC_LatchInputs();

				// Get command value (input), convert them to millivolt (from 0 to 10000 millivolt) and send them to embedded board
				InputValues[FRONT_CMD]=ADC_GetChannelVoltage(ADC_CHANNEL_FRONT);
				InputValues[REAR_CMD]=ADC_GetChannelVoltage(ADC_CHANNEL_REAR);

				sprintf (SendBuffer,">%lu,%lu\n\r",InputValues[FRONT_CMD],InputValues[REAR_CMD]);
				UART_SendData(SendBuffer, strlen(SendBuffer));
			}

			if (messageReceived==1)
			{
				Cmdprocessor(RcvBuffer, strlen(RcvBuffer));

				messageReceived=0;
			}

			messageCounter++;

			if (messageCounter>=1000) // pas de message valable recu depuis 1 seconde
			{
				messageCounter=0;

				LED_SetMode(LED_MODE_ERROR);

				UART_DeInit();
				UART_Init();
				messageReceived=0;
				UART_AddReceptionCallback(ReceptionCallback);
				UART_StartReception();
			}
		}
		/* USER CODE BEGIN 3 */
	}
	/* USER CODE END 3 */
}

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
/* USER CODE BEGIN 4 */
void ConvertOutputValues (int32_t valAnglePitch,int32_t valAngleYaw,int32_t valMdpsPitch,int32_t valMdpsYaw)
{
	// les angles sont donnés en centieme de degree et les vitesses en millieme de dps

	// Saturation de anglePitch (-45<=anglePitch<=45)
	if (valAnglePitch<-4500)
		valAnglePitch=-4500;
	else if (valAnglePitch>4500)
		valAnglePitch=4500;

	// ramener la sortie dans l'intervalle [0,10V] pour la plage d'angle [-45°,45°]
	OutputValues[ANGLE_PITCH] = ((valAnglePitch+4500)*10000l/9000l);

	// Utiliser la calibration du DAC pour rester dans l'interval [0,10V]
	OutputValues[ANGLE_PITCH] = OutputValues[ANGLE_PITCH]* DAC_CALIBRATION[ANGLE_PITCH]/10000l;


	// Saturation de mdpsPitch (-10000<=valMdpsPitch<=10000)
	if (valMdpsPitch<-10000)
		valMdpsPitch=-10000;
	else if (valMdpsPitch>10000)
		valMdpsPitch=10000;

	// ramener la sortie dans l'intervalle [0,10V] pour la plage d'angle [-20000 mdps,20000 mdps]
	OutputValues[MDPS_PITCH] = ((valMdpsPitch+10000)*10000l/20000l);

	// Utiliser la calibration du DAC pour rester dans l'interval [0,10V]
	OutputValues[MDPS_PITCH] = OutputValues[MDPS_PITCH]* DAC_CALIBRATION[MDPS_PITCH]/10000l;


	// Saturation de angleYaw (-180<=valAngleYaw<=180)
	if (valAngleYaw<-18000)
		valAngleYaw=-18000;
	else if (valAngleYaw>18000)
		valAngleYaw=18000;

	// ramener la sortie dans l'intervalle [0,10V] pour la plage d'angle [-180°,180°]
	OutputValues[ANGLE_YAW] = ((valAngleYaw+18000)*10000l/36000l);

	// Utiliser la calibration du DAC pour rester dans l'interval [0,10V]
	OutputValues[ANGLE_YAW] = OutputValues[ANGLE_YAW]* DAC_CALIBRATION[ANGLE_YAW]/10000l;


	// Saturation de mdpsYaw (-10000<=valMdpsYaw<=10000)
	if (valMdpsYaw<-10000)
		valMdpsYaw=-10000;
	else if (valMdpsYaw>10000)
		valMdpsYaw=10000;

	// ramener la sortie dans l'intervalle [0,10V] pour la plage d'angle [-20000 mdps,20000 mdps]
	OutputValues[MDPS_YAW] = ((valMdpsYaw+10000)*10000l/20000l);

	// Utiliser la calibration du DAC pour rester dans l'interval [0,10V]
	OutputValues[MDPS_YAW] = OutputValues[MDPS_YAW]* DAC_CALIBRATION[MDPS_YAW]/10000l;
}

void Cmdprocessor(char* data, uint16_t size)
{
	char *ptr=NULL;
	char *dummy=NULL;

	if (data[0] == '<')
	{
		ptr = &data[1];
		char delim[]=",";
		char *split[4]={NULL};

		split[0] = strtok(ptr, delim);
		split[1] = strtok(NULL, delim);
		split[2] = strtok(NULL, delim);
		split[3] = strtok(NULL, delim);

		valAnglePitch=strtol(split[0],&dummy,10); // Convert first part (Pitch angle) from string to long int in base 10
		valMdpsPitch=strtol(split[1],&dummy,10); // Convert second part (Pitch mdps) from string to long int in base 10
		valAngleYaw=strtol(split[2],&dummy,10); // Convert third part (Yaw angle) from string to long int in base 10
		valMdpsYaw=strtol(split[3],&dummy,10); // Convert fourth part (yaw mdps) from string to long int in base 10

		ConvertOutputValues (valAnglePitch,valAngleYaw,valMdpsPitch,valMdpsYaw);
	}
	else //unknown frame, drop it
	{
		// nothing to do
	}
}

void ReceptionCallback(char* data, uint16_t size)
{
	messageCounter=0;

	if (messageReceived!=1)
		strcpy(RcvBuffer,data);

	messageReceived=1;
}
/* USER CODE END 4 */
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
