INSA-GEI/Helicoptere/software/Helicoptere_Embarque/Helicoptere_Embarque_FW.ioc

Mcu.UserName=STM32L432KCUx
PA0.GPIO_Label=MCO [High speed clock in]
PA0.Signal=RCC_CK_IN
PA1.GPIO_Label=SENSOR_INT
PA1.Signal=GPXTI1
PA10.Signal=USART1_RX
PA11.Signal=S_TIM1_CH4
PA2.Signal=USART2_TX
PA3.Signal=USART2_RX
PA8.Signal=S_TIM1_CH1
PA9.Signal=USART1_TX
PB6.Signal=I2C1_SCL
PB7.Signal=I2C1_SDA
