INSA-GEI/Helicoptere/software/Helicoptere_Base/Inc/main.h

#define USART_TX_Pin GPIO_PIN_2
#define USART_TX_GPIO_Port GPIOA
#define USART_RX_Pin GPIO_PIN_3
#define USART_RX_GPIO_Port GPIOA
#define DAC_SYNC_Pin GPIO_PIN_4
#define DAC_SYNC_GPIO_Port GPIOA
#define DAC_CLK_Pin GPIO_PIN_5
#define DAC_CLK_GPIO_Port GPIOA
#define DAC_DATA_Pin GPIO_PIN_7
#define DAC_DATA_GPIO_Port GPIOA
#define TMS_Pin GPIO_PIN_13
#define TMS_GPIO_Port GPIOA
#define TCK_Pin GPIO_PIN_14
#define TCK_GPIO_Port GPIOA
#define LED_Pin GPIO_PIN_3
#define LED_GPIO_Port GPIOB
