INSA-GEI/Helicoptere/(commit log)

2019-09-24 Etat initial
    [Bague.FCStd, Bague.dwg, Bague.ipt, Bague.step, Base.FCStd, Base.ipt, Base.step, Bouchon PVC.ipt]
2019-09-27 Etape intermediaire
    [Carte_Convertion.kicad_pcb, Carte_Convertion.sch, carte_base.kicad_pcb, carte_base.sch]
2019-10-01 Carte base finie
    [SRN6028 series.stp, STEP-WE-PD-6033-rev1.stp, STEP-WE-PD-7332-Metal-rev1.stp, STP_MAX-WE-PD-6033-rev1.stp, carte_base.kicad_pcb, carte_base.sch]
2019-10-03 Carte embarquée terminée
    [carte_embarque.kicad_pcb, carte_embarque.sch]
2019-10-03 Correction sur carte base
    [carte_base.kicad_pcb, carte_base.sch]
2019-10-11 petites evolutions sur PCB
    [carte_base.kicad_pcb, carte_base.sch, carte_embarque.kicad_pcb]
2019-11-13 creation du projet logiciel Helicoptere_embarque
    [carte_base.sch]
2019-11-15 ajout des drivers usart (XBEE et BASE_COM) et de l'accelero_gyro. Les usarts semblent bien marcher, mais l'accelero ne marche pas encore (pb d'I2C)
2019-11-18 Reglage du gyrosocpe et de l'accelerometre, ajout de routine AHRS
2019-11-19 AHRS raisonnablement stable et fonctionnel F=500Hz mais probleme autour de +/-180°
    [acc_gyro.c, acc_gyro.h, main.c, main.h]
2019-11-29 Periph soft de base OK
2019-12-09 Multiple evolutions et corrections
    [acc_gyro.c, adc.c, base_com.c, debug.h, main.c, main.h]
2019-12-10 Changement de loi AHRS
2020-06-23 Ajout de la doc, premier draft
    [carte_embarque.sch]
